Circuit-Digest/Wireless-Stepper-Motor-Controller/README.md

# Wireless-Stepper-Motor-Controller
The Wireless Stepper Driver is a compact and efficient motion control system designed to control stepper motors over Wi-Fi.
