Circuit-Digest/Wireless-Stepper-Motor-Controller/PCB/Wireless_Stepper_Motor _Controller/Wireless_Stepper_Motor _Controller Back.png

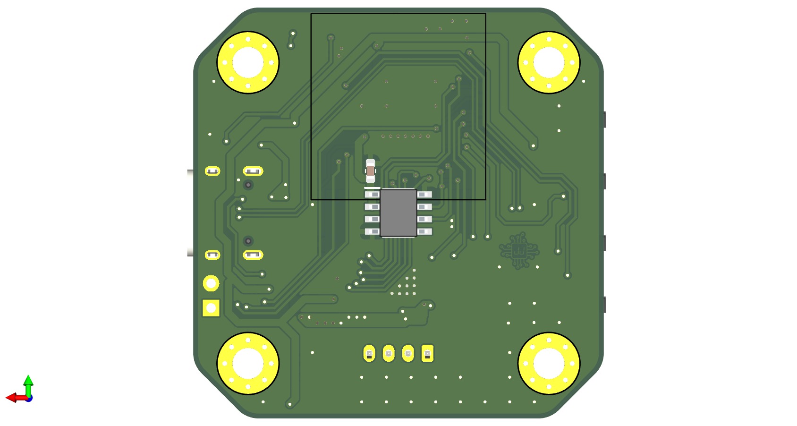
PCB/Wireless_Stepper_Motor _Controller/Wireless_Stepper_Motor _Controller Back.png
