Circuit-Digest/Wireless-Stepper-Motor-Controller/PCB/Wireless_Stepper_Motor _Controller/Schematic.pdf

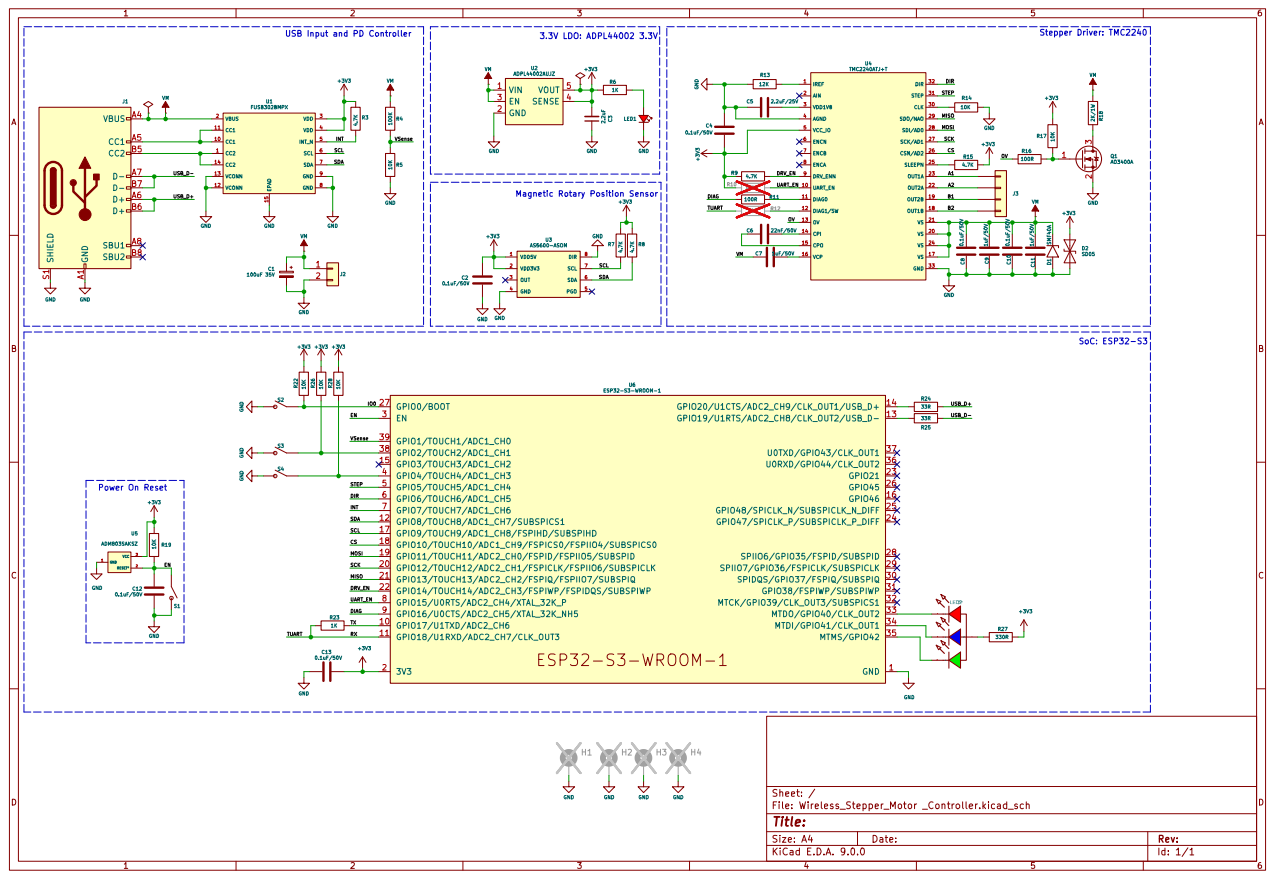
[picture p3: page 1]
