Circuit-Digest/Wireless-Stepper-Motor-Controller/PCB/Wireless_Stepper_Motor _Controller/Wireless_Stepper_Motor _Controller.kicad_pcb

## KiCad design PCB/Wireless_Stepper_Motor _Controller/Wireless_Stepper_Motor _Controller.kicad_pcb (2025-05-28)

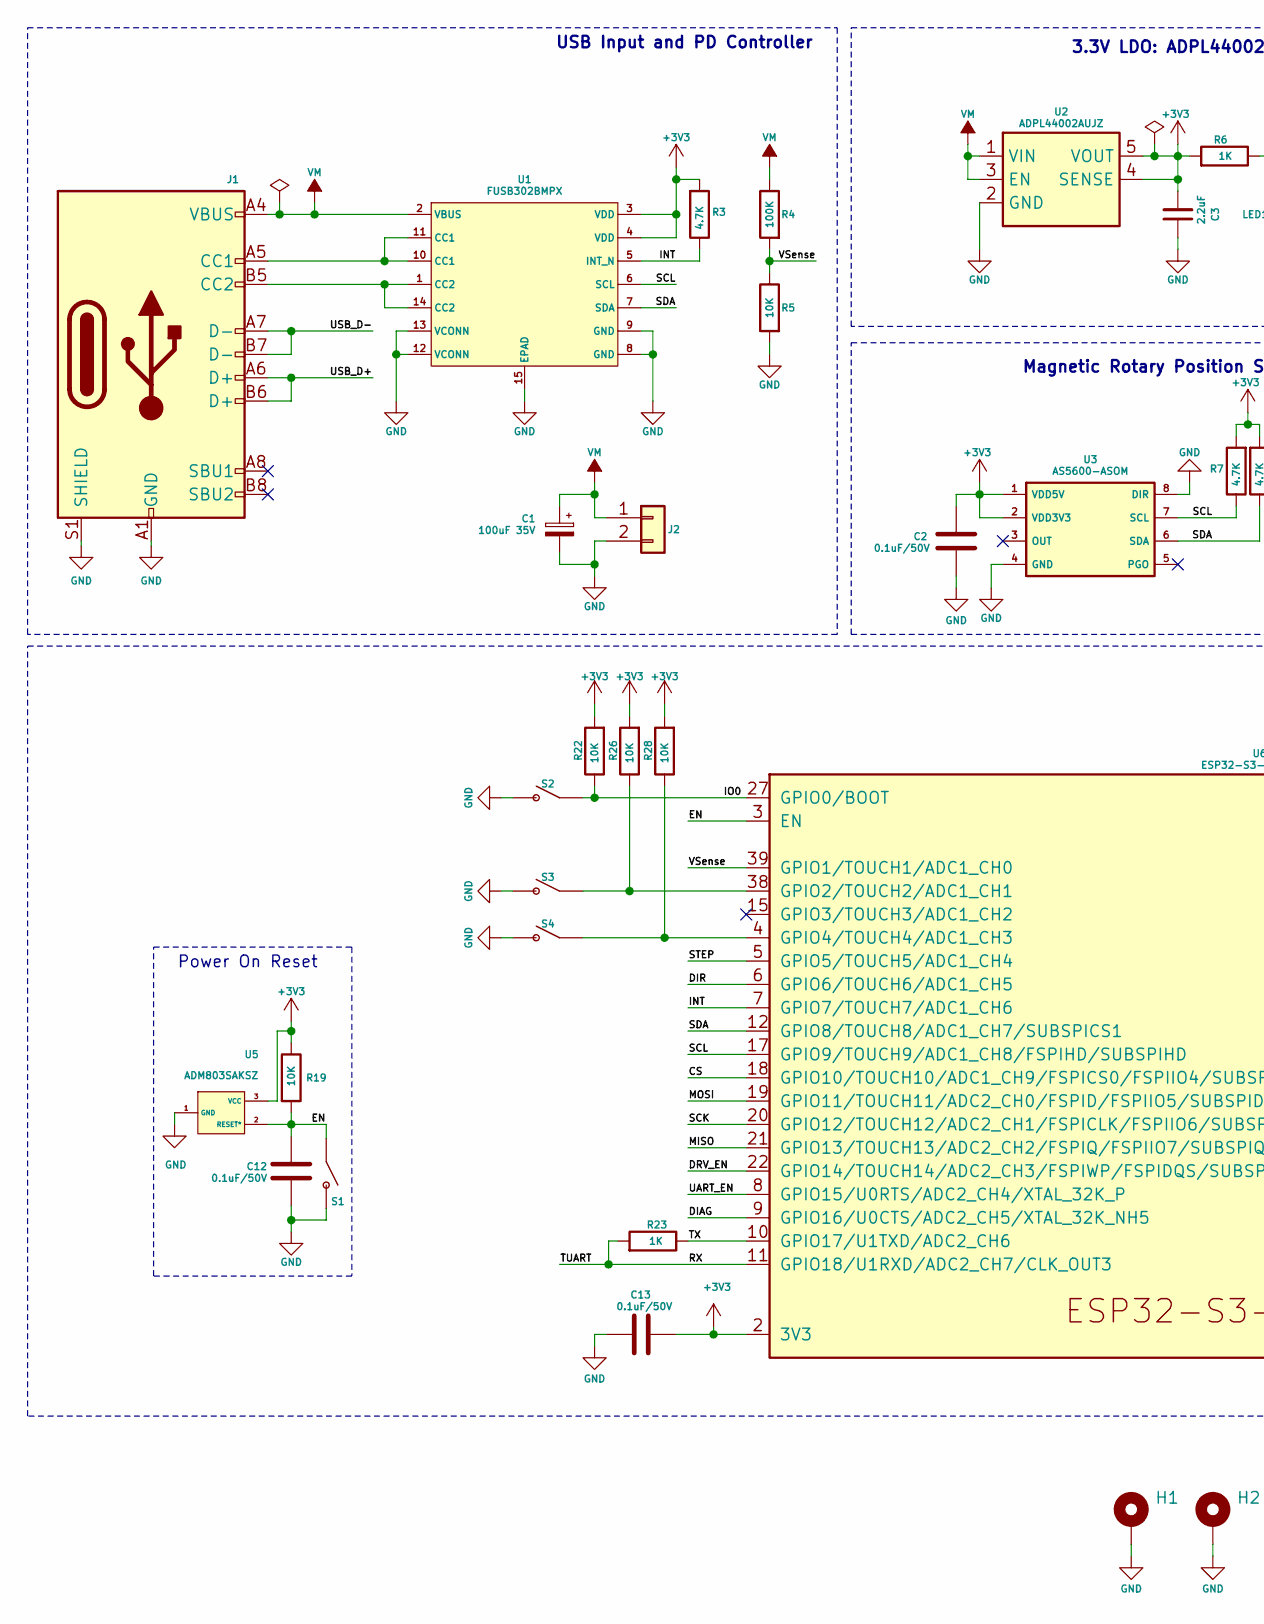
[picture p4: schematic Wireless_Stepper_Motor _Controller.kicad_sch, part in row 1, column 1]

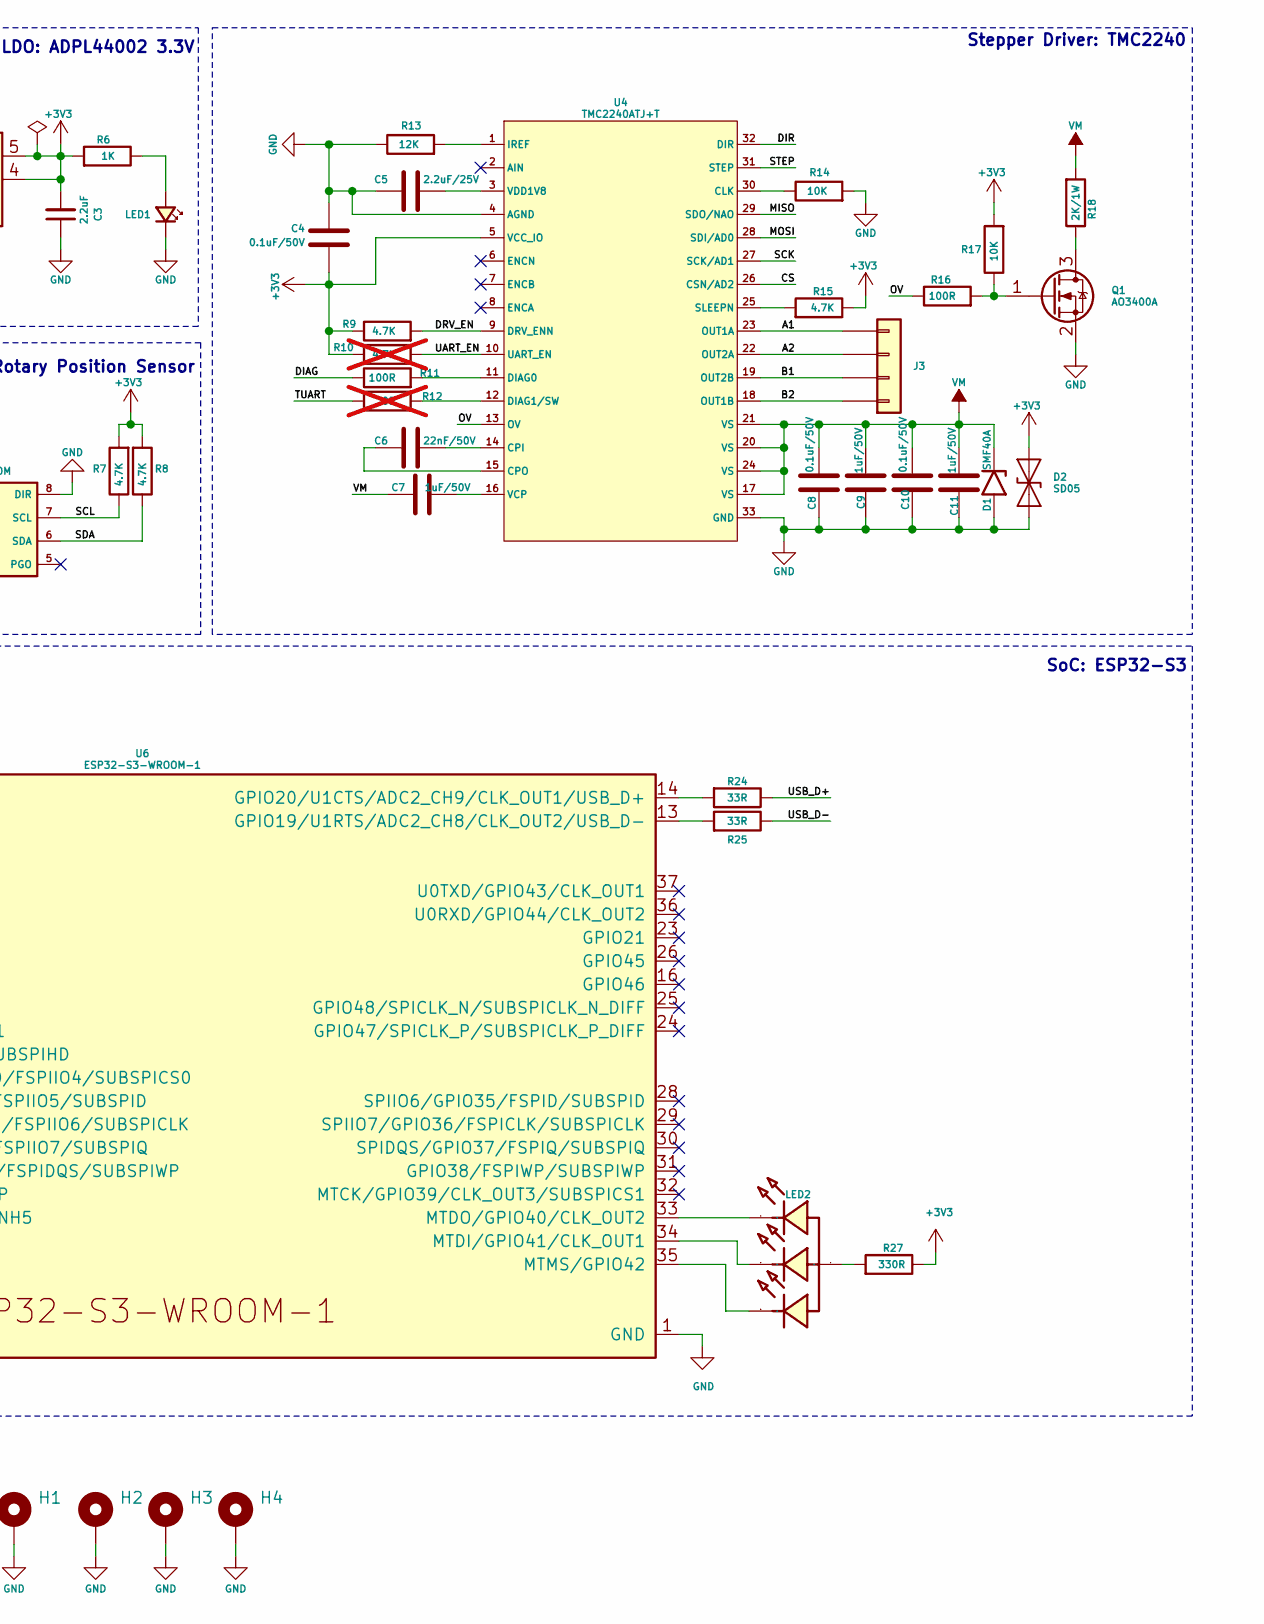
[picture p5: schematic Wireless_Stepper_Motor _Controller.kicad_sch, part in row 1, column 2]

Parts:
C1: 100uF 35V; CP_Elec_6.3x5.4
C2, C4, C8, C10, C12, C13: 0.1uF/50V; C_0603_1608Metric; DigiKey Part Number 490-6328-1-ND
C3: 2.2uF; C_0603_1608Metric
C5: 2.2uF/25V; C_0603_1608Metric; DigiKey Part Number 490-6328-1-ND
C6: 22nF/50V; C_0603_1608Metric; DigiKey Part Number 490-6328-1-ND
C7, C9, C11: 1uF/50V; C_0603_1608Metric; DigiKey Part Number 490-6328-1-ND
D1: SMF40A; D_SMF
D2: SD05; D_SOD-323
H1, H2, H3, H4: MountingHole_Pad; MountingHole_3.2mm_M3_Pad_Via
J1: USB_C_Receptacle_USB2.0; USB_C_Receptacle_XKB_U262-16XN-4BVC11; DigiKey Part Number 2073-USB4105-GF-ACT-ND
J2: Conn_01x02; PinHeader_1x02_P2.54mm_Vertical
J3: Conn_01x04; JST_PH_S4B-PH-K_1x04_P2.00mm_Horizontal
LED1: LED_Small; LED_0603_1608Metric
LED2: XL-1615RGBC-YG; LED-SMD_4P-L1.6-W1.5-BL-2; Manufacturer Part XL-1615RGBC-YG
Q1: AO3400A; SOT-23
R3, R7, R8, R9, R15: 4.7K; R_0603_1608Metric; DigiKey Part Number P10.0KHCT-ND
R4: 100K; R_0603_1608Metric; DigiKey Part Number P5.10KHCT-ND
R5: 10K; R_0603_1608Metric; DigiKey Part Number P5.10KHCT-ND
R6, R23: 1K; R_0603_1608Metric; DigiKey Part Number P10.0KHCT-ND
R10: 4.7K; R_0603_1608Metric; DigiKey Part Number P10.0KHCT-ND; not fitted
R11, R16: 100R; R_0603_1608Metric; DigiKey Part Number P10.0KHCT-ND
R12: 0R; R_0603_1608Metric; DigiKey Part Number P10.0KHCT-ND; not fitted
R13: 12K; R_0603_1608Metric; DigiKey Part Number P10.0KHCT-ND
R14, R17, R19, R22, R26, R28: 10K; R_0603_1608Metric; DigiKey Part Number P10.0KHCT-ND
R18: 2K/1W; R_1206_3216Metric; DigiKey Part Number P10.0KHCT-ND
R24, R25: 33R; R_0603_1608Metric; DigiKey Part Number P17467CT-ND
R27: 330R; R_0603_1608Metric; DigiKey Part Number P10.0KHCT-ND
S1, S2, S3, S4: EVQ-P7A01P; SW_EVQ-P7A01P; PARTREV 2022.4
U1: FUSB302BMPX; MLP14_2P5X2P5_ONS
U2: ADPL44002AUJZ; SOT95P280X100-5N; Manufacturer_Part_Number ADPL44002AUJZ2.5-R7
U3: AS5600-ASOM; SOIC127P600X175-8N; Mouser Part Number 985-AS5600-ASOM
U4: TMC2240ATJ+T; 21-0140_T3255&plus_5C_TRI
U5: ADM803SAKSZ; KS_3_ADI; DigiKey Part Number 505-ADM803SAKSZ-REEL7CT-ND
U6: ESP32-S3-WROOM-1; ESP32-S3-WROOM-1U; DigiKey Part Number 1965-ESP32-S3-WROOM-1-N16R8CT-ND

Connections:
+3V3: C2.1, C3.2, C4.2, C13.1, D2.1 (A1), R3.2, R6.2, R7.2, R8.2, R9.1, R10.1, R15.1, R17.2, R19.1, R22.2, R26.2, R27.1, R28.2, U1.3 (VDD), U1.4 (VDD), U2.4 (SENSE), U2.5 (VOUT), U3.1 (VDD5V), U3.2 (VDD3V3), U4.5 (VCC_IO), U5.3 (VCC), U6.2 (3V3)
/A1: J3.4, U4.23 (OUT1A)
/A2: J3.3, U4.22 (OUT2A)
/B1: J3.2, U4.19 (OUT2B)
/B2: J3.1, U4.18 (OUT1B)
/CS: U4.26 (CSN/AD2), U6.18 (GPIO10/TOUCH10/ADC1_CH9/FSPICS0/FSPIIO4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)
/DIAG: R11.1, U6.9 (GPIO16/U0CTS/ADC2_CH5/XTAL_32K_NH5)
/DIR: U4.32 (DIR), U6.6 (GPIO6/TOUCH6/ADC1_CH5)
/DRV_EN: R9.2, U4.9 (DRV_ENN), U6.22 (GPIO14/TOUCH14/ADC2_CH3/FSPIWP/FSPIDQS/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)
/EN: C12.1, R19.2, S1.1_1, S1.1_2, U5.2 (RESET*), U6.3 (EN)
/INT: R3.1, U1.5 (INT_N), U6.7 (GPIO7/TOUCH7/ADC1_CH6)
/IO0: R22.1, S2.1_1, S2.1_2, U6.27 (GPIO0/BOOT)
/MISO: U4.29 (SDO/NAO), U6.21 (GPIO13/TOUCH13/ADC2_CH2/FSPIQ/FSPIIO7/S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)
/MOSI: U4.28 (SDI/AD0), U6.19 (GPIO11/TOUCH11/ADC2_CH0/FSPID/FSPIIO5/S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)
/OV: R16.1, U4.13 (OV)
/RX: R12.1, R23.2, U6.11 (GPIO18/U1RXD/ADC2_CH7/CLK_OUT3)
/SCK: U4.27 (SCK/AD1), U6.20 (GPIO12/TOUCH12/ADC2_CH1/FSPICLK/FSPIIO6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)
/SCL: R7.1, U1.6 (SCL), U3.7 (SCL), U6.17 (GPIO9/TOUCH9/ADC1_CH8/FSPIHD/SUBSPIHD)
/SDA: R8.1, U1.7 (SDA), U3.6 (SDA), U6.12 (GPIO8/TOUCH8/ADC1_CH7/SUBSPICS1)
/STEP: U4.31 (STEP), U6.5 (GPIO5/TOUCH5/ADC1_CH4)
/TX: R23.1, U6.10 (GPIO17/U1TXD/ADC2_CH6)
/UART_EN: R10.2, U4.10 (UART_EN), U6.8 (GPIO15/U0RTS/ADC2_CH4/XTAL_32K_P)
/USB_D+: J1.A6 (D+), J1.B6 (D+), R24.1
/USB_D-: J1.A7 (D-), J1.B7 (D-), R25.1
/VSense: R4.2, R5.1, U6.39 (GPIO1/TOUCH1/ADC1_CH0)
GND: C1.2, C2.2, C3.1, C4.1, C5.2, C8.2, C9.1, C10.2, C11.1, C12.2, C13.2, D1.2 (A2), D2.2 (A2), H1.1, H2.1, H3.1, H4.1, J1.A1 (GND), J1.A12 (GND), J1.B1 (GND), J1.B12 (GND), J1.S1 (SHIELD), J2.2, LED1.1 (K), Q1.2 (S), R5.2, R13.1, R14.2, S1.2_1, S1.2_2, S2.2_1, S2.2_2, S3.2_1, S3.2_2, S4.2_1, S4.2_2, U1.8 (GND), U1.9 (GND), U1.12 (VCONN), U1.13 (VCONN), U1.15 (EPAD), U2.2 (GND), U3.4 (GND), U3.8 (DIR), U4.4 (AGND), U4.33 (GND), U5.1 (GND), U6.1 (GND), U6.40 (GND), U6.41 (GND)
unnamed: J1.A5 (CC1), U1.10 (CC1), U1.11 (CC1)
unnamed: J1.B5 (CC2), U1.1 (CC2), U1.14 (CC2)
unnamed: LED1.2 (A), R6.1
unnamed: LED2.1 (A), R27.2
unnamed: Q1.3 (D), R18.1
unnamed: Q1.1 (G), R16.2, R17.1
unnamed: R14.1, U4.30 (CLK)
unnamed: C6.1, U4.14 (CPI)
unnamed: C6.2, U4.15 (CPO)
unnamed: R11.2, U4.11 (DIAG0)
unnamed: R12.2, U4.12 (DIAG1/SW)
unnamed: R13.2, U4.1 (IREF)
unnamed: R15.2, U4.25 (SLEEPN)
unnamed: C7.2, U4.16 (VCP)
unnamed: C5.1, U4.3 (VDD1V8)
unnamed: R26.1, S3.1_1, S3.1_2, U6.38 (GPIO2/TOUCH2/ADC1_CH1)
unnamed: R28.1, S4.1_1, S4.1_2, U6.4 (GPIO4/TOUCH4/ADC1_CH3)
unnamed: R25.2, U6.13 (GPIO19/U1RTS/ADC2_CH8/CLK_OUT2/USB_D-)
unnamed: R24.2, U6.14 (GPIO20/U1CTS/ADC2_CH9/CLK_OUT1/USB_D+)
unnamed: LED2.3 (K), U6.34 (MTDI/GPIO41/CLK_OUT1)
unnamed: LED2.2 (K), U6.33 (MTDO/GPIO40/CLK_OUT2)
unnamed: LED2.4 (K), U6.35 (MTMS/GPIO42)
VM: C1.1, C7.1, C8.1, C9.2, C10.1, C11.2, D1.1 (A1), J1.A4 (VBUS), J1.A9 (VBUS), J1.B4 (VBUS), J1.B9 (VBUS), J2.1, R4.1, R18.2, U1.2 (VBUS), U2.1 (VIN), U2.3 (EN), U4.17 (VS), U4.20 (VS), U4.21 (VS), U4.24 (VS)

Notes on the sheet:
3.3V LDO: ADPL44002 3.3V
Power On Reset
Stepper Driver: TMC2240
Magnetic Rotary Position Sensor
SoC: ESP32-S3
USB Input and PD Controller

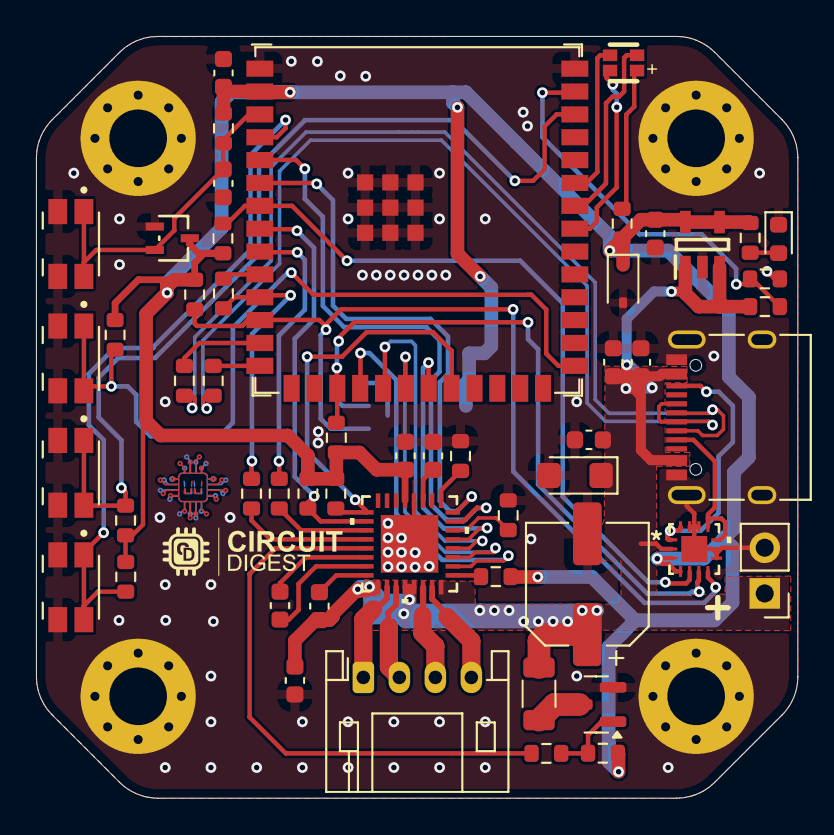
[picture p6: board Wireless_Stepper_Motor _Controller.kicad_pcb from above]

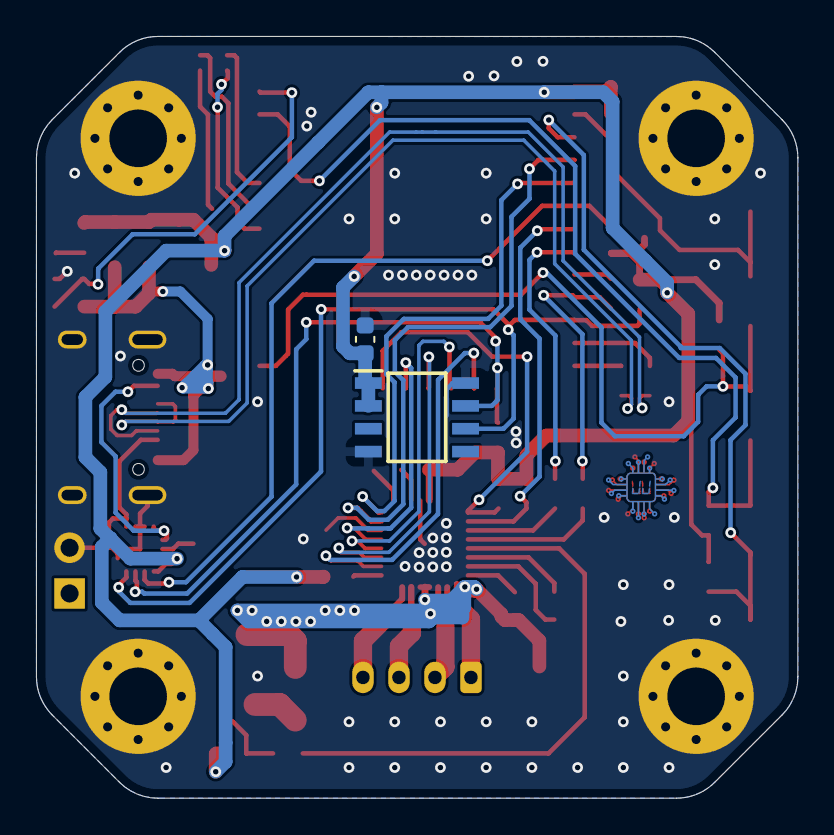
[picture p7: board Wireless_Stepper_Motor _Controller.kicad_pcb from below]

Board: 2 copper layers, 42.3 x 42.3 mm, 59 parts (2 on the bottom side), 49 nets.
